microsysdeve/fjl_sdlk/电气控制原理.docx

山东里可涂装工程有限公司

自动电泳线电气控制原理

（热风循环）

7.5kw 风机启动 然后才能启动（燃烧机 三相电1.5kw）（金工热能表控制）

燃烧机关机后风机进入 延时0-30分钟（可调） 后自动关闭

烘道热能水循环

启动后由一台（百特工控）温控表（无需安装在面板上，放在控制柜内部），设定高报警，超出设定温度后启动1.5kw 水泵循环，低于设定温度，水泵自动停止工作.水泵为三相

悬挂链

由两台 三菱E740-3.7KW 变频器 同步运行，外接电位器，外接0-10v 转速表（可校准），外接急停，复位后方可自动运行（不需要写入PLC，安装面板按钮）

热水炉

燃烧机 0.75kw 两相电（由霍宇温控表单独控制启停） 水泵5.5kw三相电 关联四台 24v 电动执行器，执行器由霍宇温控表控制开与关，当四台执行器全部关闭状态，水泵自动停止，如任意一台执行器自动打开，水泵自动重启

目前张家港双荣的这部分控制有问题 需要整改

前处理

预脱脂 7.5kw水泵 主脱脂7.5kw水泵 主脱脂浸 5.5kw水泵 水洗一4kw水泵 水洗二浸 4kw水泵 纯水三 4kw水泵 硅烷7.5kw水泵 纯水四 4kw水泵 纯水五 4kw水泵 纯水六4kw水泵

电泳

轴封冷却泵 0.55kw 水泵启动后才能启动 电泳泵与超滤泵

电泳泵循环 15kw

UF1 4kw水泵 UF2 4kw 水泵 UF3 4kw水泵 纯水洗 4kw水泵

超滤泵 11kw ，有一个高液位保护，当水位过高超滤泵自动关闭，并且发出声光报警，声光报警器ALM1

反冲洗泵 1.5kw 单独启停

UF0喷淋 1.5kw

超滤液循环泵1.5kw 由低液位控制自动启停，液位到达自动启动（同时控制内循环电磁阀）

外循环 由中液位探针控制一个24v 电磁阀 开与关G1

内循环 由低液位探针控制一个24v 电磁阀 开与关G2

以上三个液位 共用一个 高 中 低 三针式水位控制器

一个16A 两相照明 时段控制可调

备用 手动控制一个220v 电磁阀 开与关.G3

备用电源 不需写入PLC

两相电源空开 2P 16A 5个

三相 16A 2个

三相40A 2个

三相63A 2个

注意要求：

所有马达均为三相380v

所有三相电机 需要热保护

总电源需要缺相保护

面板上有一个电流表，一个电压表

三个电源指示

一个总控制启动按钮，一个总控急停

金工热能 技术电话：张工18962452610
