microsysdeve/fjl_sdlk/热水炉.pdf

## 热水炉

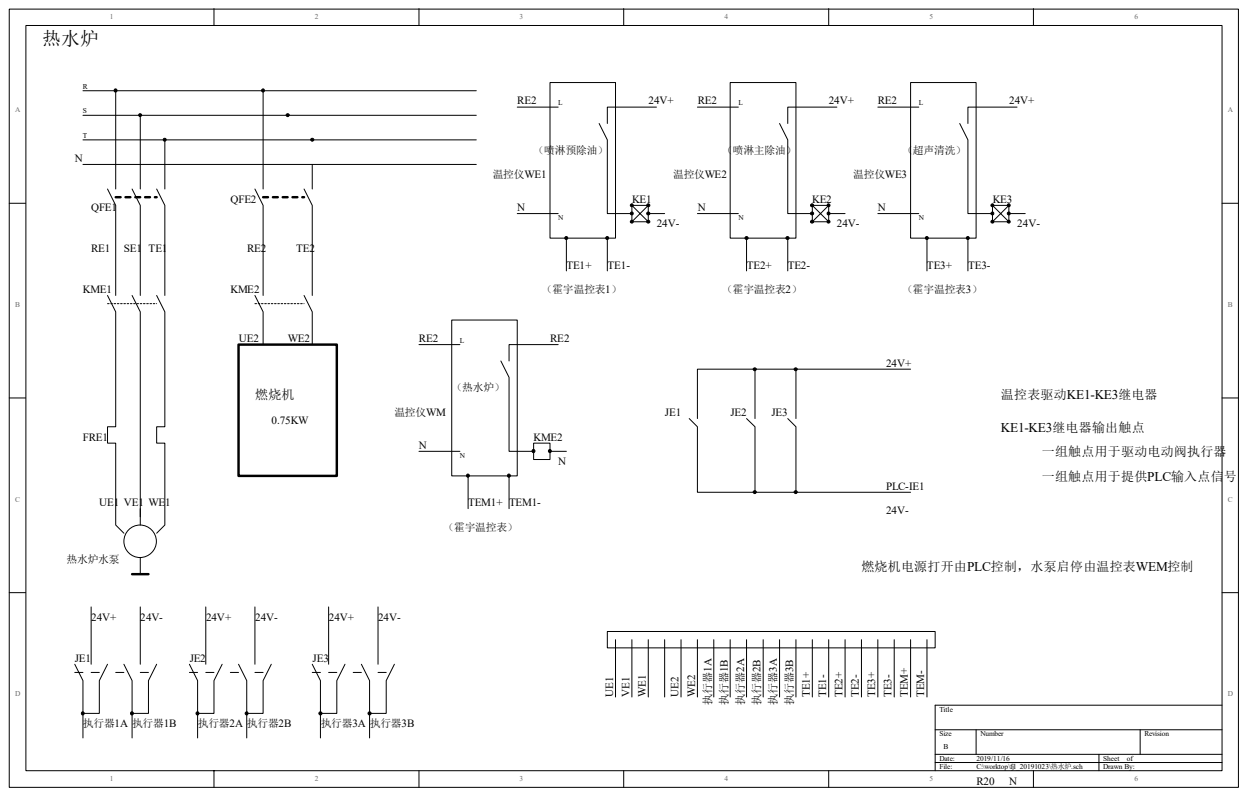
[picture p1: page 1]
Title; KME1; QFE1; FRE1; KME2; QFE2; 热水炉水泵; 燃烧机; 温控仪WE2; PLC-IE1; 执行器2B; 执行器3A; 执行器3B; 执行器2A; 执行器1B; 执行器1A; （霍宇温控表2）; 温控仪WE3; （霍宇温控表3）; 温控仪WE1; （霍宇温控表1）; 执行器1A 执行器1B; 24V- 执行器2A 执行器2B; 24V- 执行器3A 执行器3B; 温控表驱动KE1-KE3继电器; KE1-KE3继电器输出触点; 一组触点用于驱动电动阀执行器; 一组触点用于提供PLC输入点信号; 温控仪WM; （霍宇温控表）; TEM1+; TEM1-; TEM+; TEM-; 燃烧机电源打开由PLC控制，水泵启停由温控表WEM控制; （喷淋预除油）; （超声清洗） （喷淋主除油）; （热水炉）

Size B | Number | Revision

1 2 3 4 | Date: 2019/11/16 Sheet of File: C:\worktop\fjl_20191023\热水炉.sch Drawn By: 5 R20 N 6
