microsysdeve/fjl_sdlk/fjl_sdlk.pdf

# 山东里可涂装工程有限公司

# 自动电泳线电气控制原理

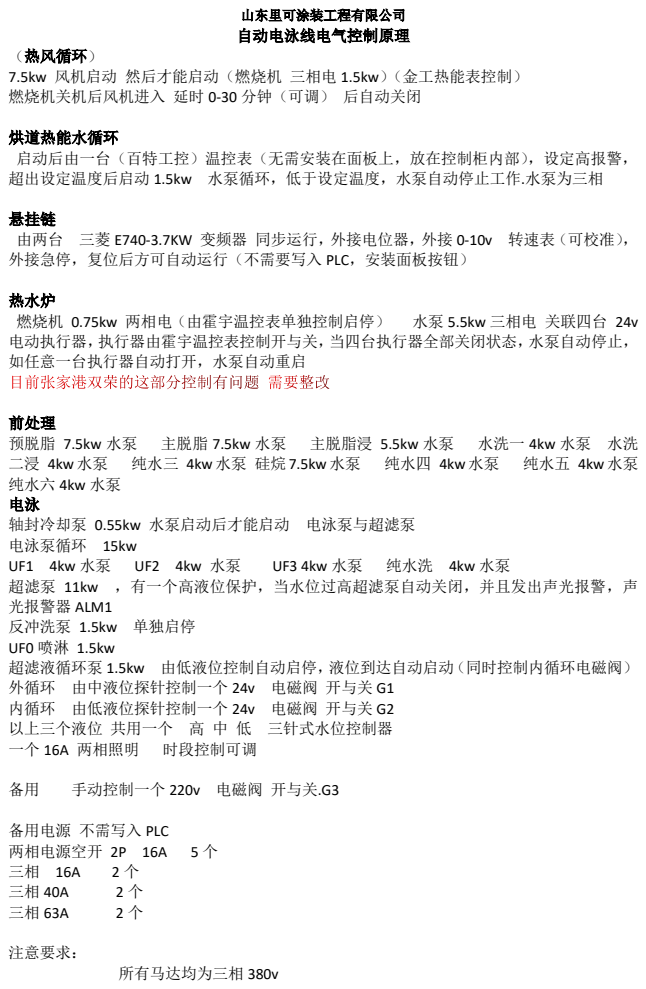
[picture p2: page 1]
燃烧机 0.75kw 两相电（由霍宇温控表单独控制启停）; 水泵 5.5kw 三相电 关联四台 24v; 预脱脂 7.5kw 水泵; 主脱脂 7.5kw 水泵; 主脱脂浸 5.5kw 水泵; 水洗一 4kw 水泵 水洗; 纯水三 4kw 水泵 硅烷 7.5kw 水泵; 纯水四 4kw 水泵; 纯水五 4kw 水泵; 纯水洗 4kw 水泵; 一个 16A 两相照明; 时段控制可调; 手动控制一个 220v 电磁阀 开与关.G3; 两相电源空开 2P 16A; 注意要求：; 所有马达均为三相 380v

（热风循环）
7.5kw 风机启动 然后才能启动（燃烧机 三相电 1.5kw）（金工热能表控制）
燃烧机关机后风机进入 延时 0-30 分钟（可调） 后自动关闭

烘道热能水循环
启动后由一台（百特工控）温控表（无需安装在面板上，放在控制柜内部），设定高报警，
超出设定温度后启动 1.5kw 水泵循环，低于设定温度，水泵自动停止工作.水泵为三相

悬挂链
由两台 三菱 E740-3.7KW 变频器 同步运行，外接电位器，外接 0-10v 转速表（可校准），
外接急停，复位后方可自动运行（不需要写入 PLC，安装面板按钮）

热水炉
电动执行器，执行器由霍宇温控表控制开与关，当四台执行器全部关闭状态，水泵自动停止，
如任意一台执行器自动打开，水泵自动重启

前处理
纯水六 4kw 水泵
轴封冷却泵 0.55kw 水泵启动后才能启动 电泳泵与超滤泵
电泳泵循环 15kw
超滤泵 11kw ，有一个高液位保护，当水位过高超滤泵自动关闭，并且发出声光报警，声
光报警器 ALM1
反冲洗泵 1.5kw 单独启停
超滤液循环泵 1.5kw 由低液位控制自动启停，液位到达自动启动（同时控制内循环电磁阀）
外循环 由中液位探针控制一个 24v 电磁阀 开与关 G1
内循环 由低液位探针控制一个 24v 电磁阀 开与关 G2
以上三个液位 共用一个 高 中 低 三针式水位控制器

备用电源 不需写入 PLC

# 所有三相电机 需要热保护 总电源需要缺相保护 面板上有一个电流表，一个电压表 三个电源指示 一个总控制启动按钮，一个总控急停

# 金工热能 技术电话：张工 18962452610

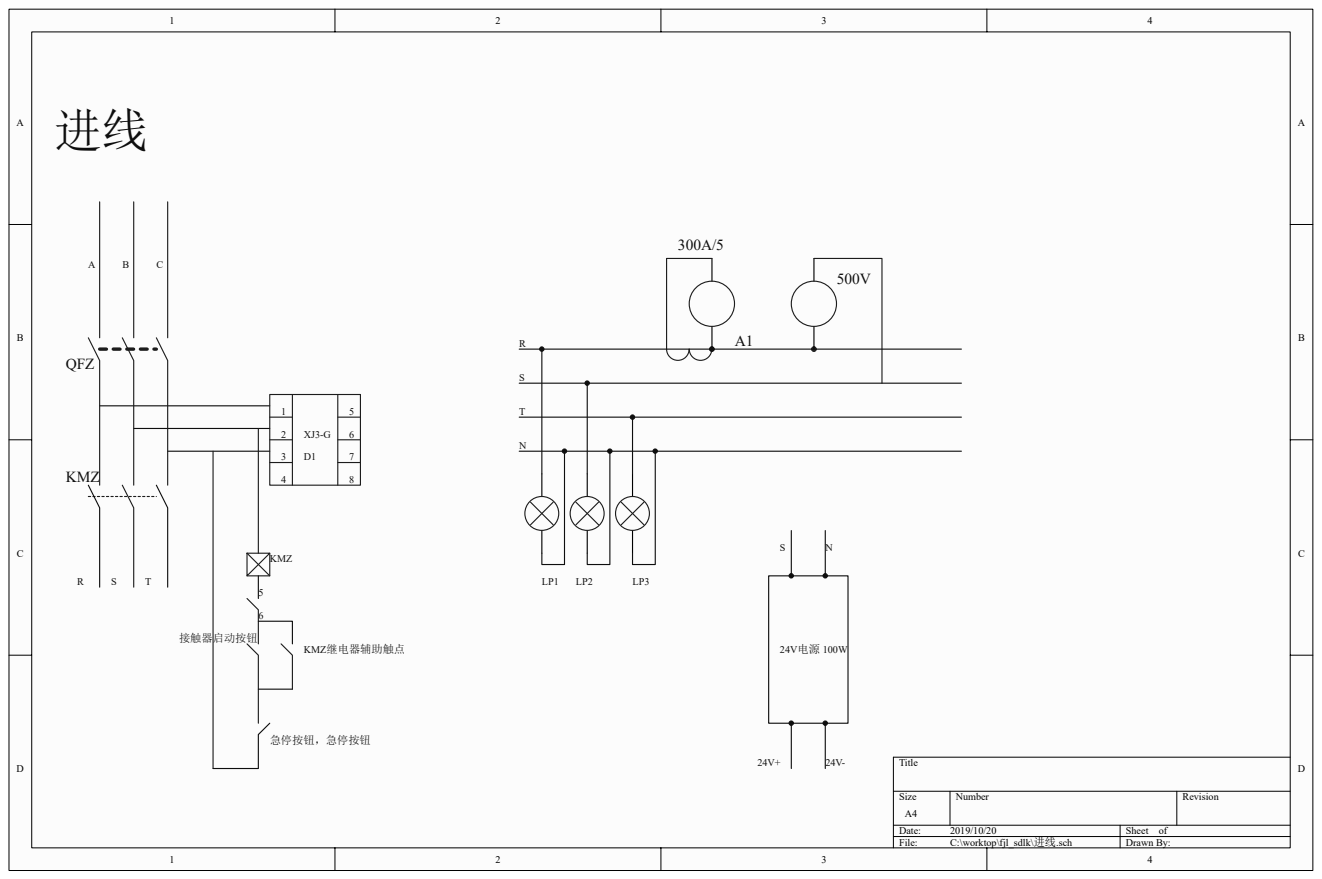
[picture p3: page 3]
Title; KMZ; QFZ; 24V电源 100W; 急停按钮，急停按钮 KMZ继电器辅助触点 接触器启动按钮

Size A4 | Number | Revision

Date: 2019/10/20 | Sheet of
File: C:\worktop\fjl_sdlk\进线.sch | Drawn By:

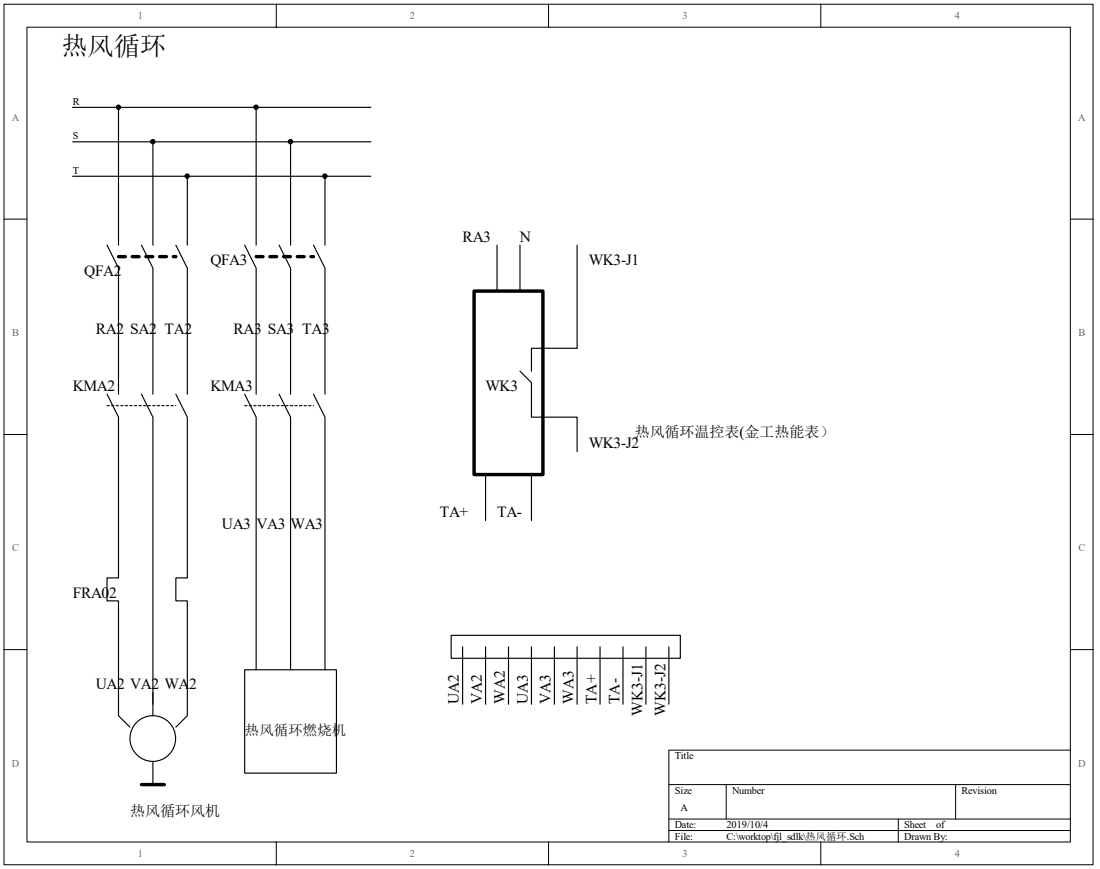
[picture p4: page 4]
Title; KMA2; QFA2; FRA02; KMA3; QFA3; 热风循环燃烧机; 热风循环风机; 热风循环温控表(金工热能表）; 热风循环

Size A | Number | Revision

Date: 2019/10/4 | Sheet of
File: C:\worktop\fjl_sdlk\热风循环.Sch | Drawn By:

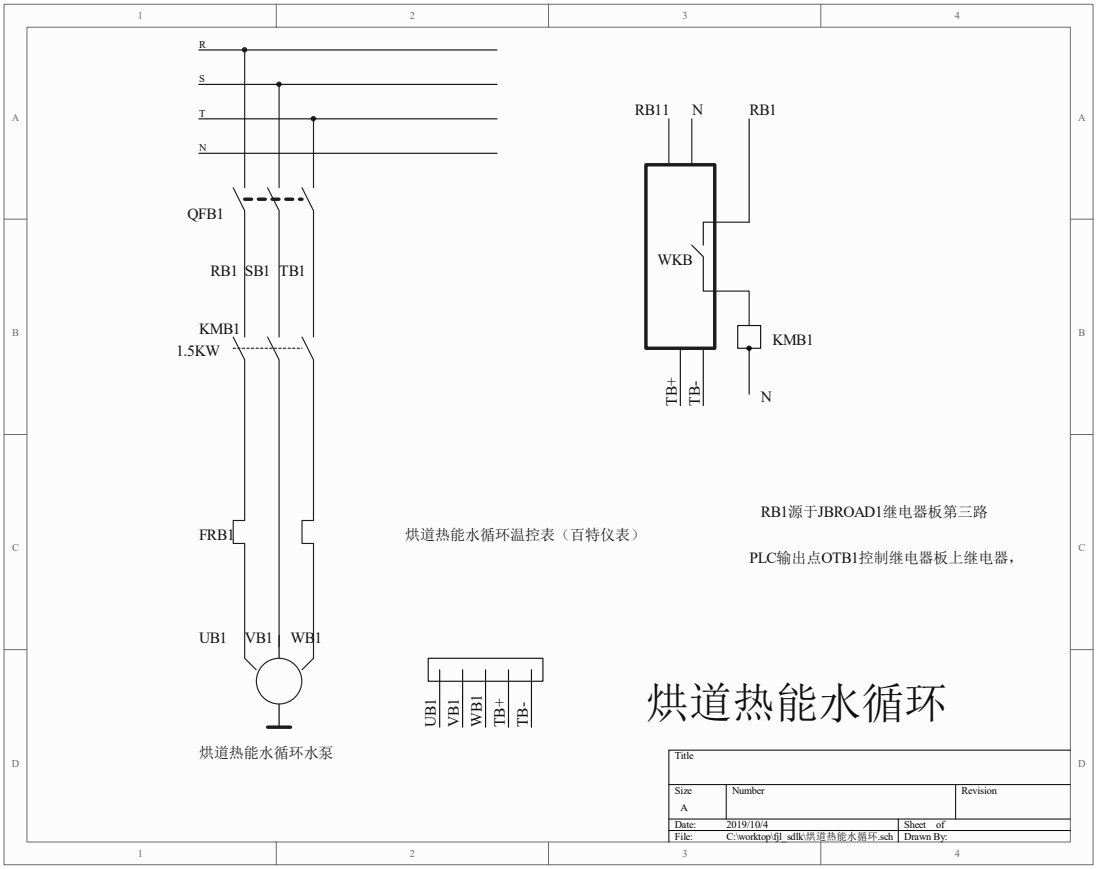
[picture p5: page 5]
Title; KMB1; QFB1; FRB1; 烘道热能水循环水泵; 烘道热能水循环温控表（百特仪表）; WKB; PLC输出点OTB1控制继电器板上继电器，; 烘道热能水循环; RB1源于JBROAD1继电器板第三路

Size A | Number | Revision

Date: 2019/10/4 | Sheet of
File: C:\worktop\fjl_sdlk\烘道热能水循环.sch | Drawn By:

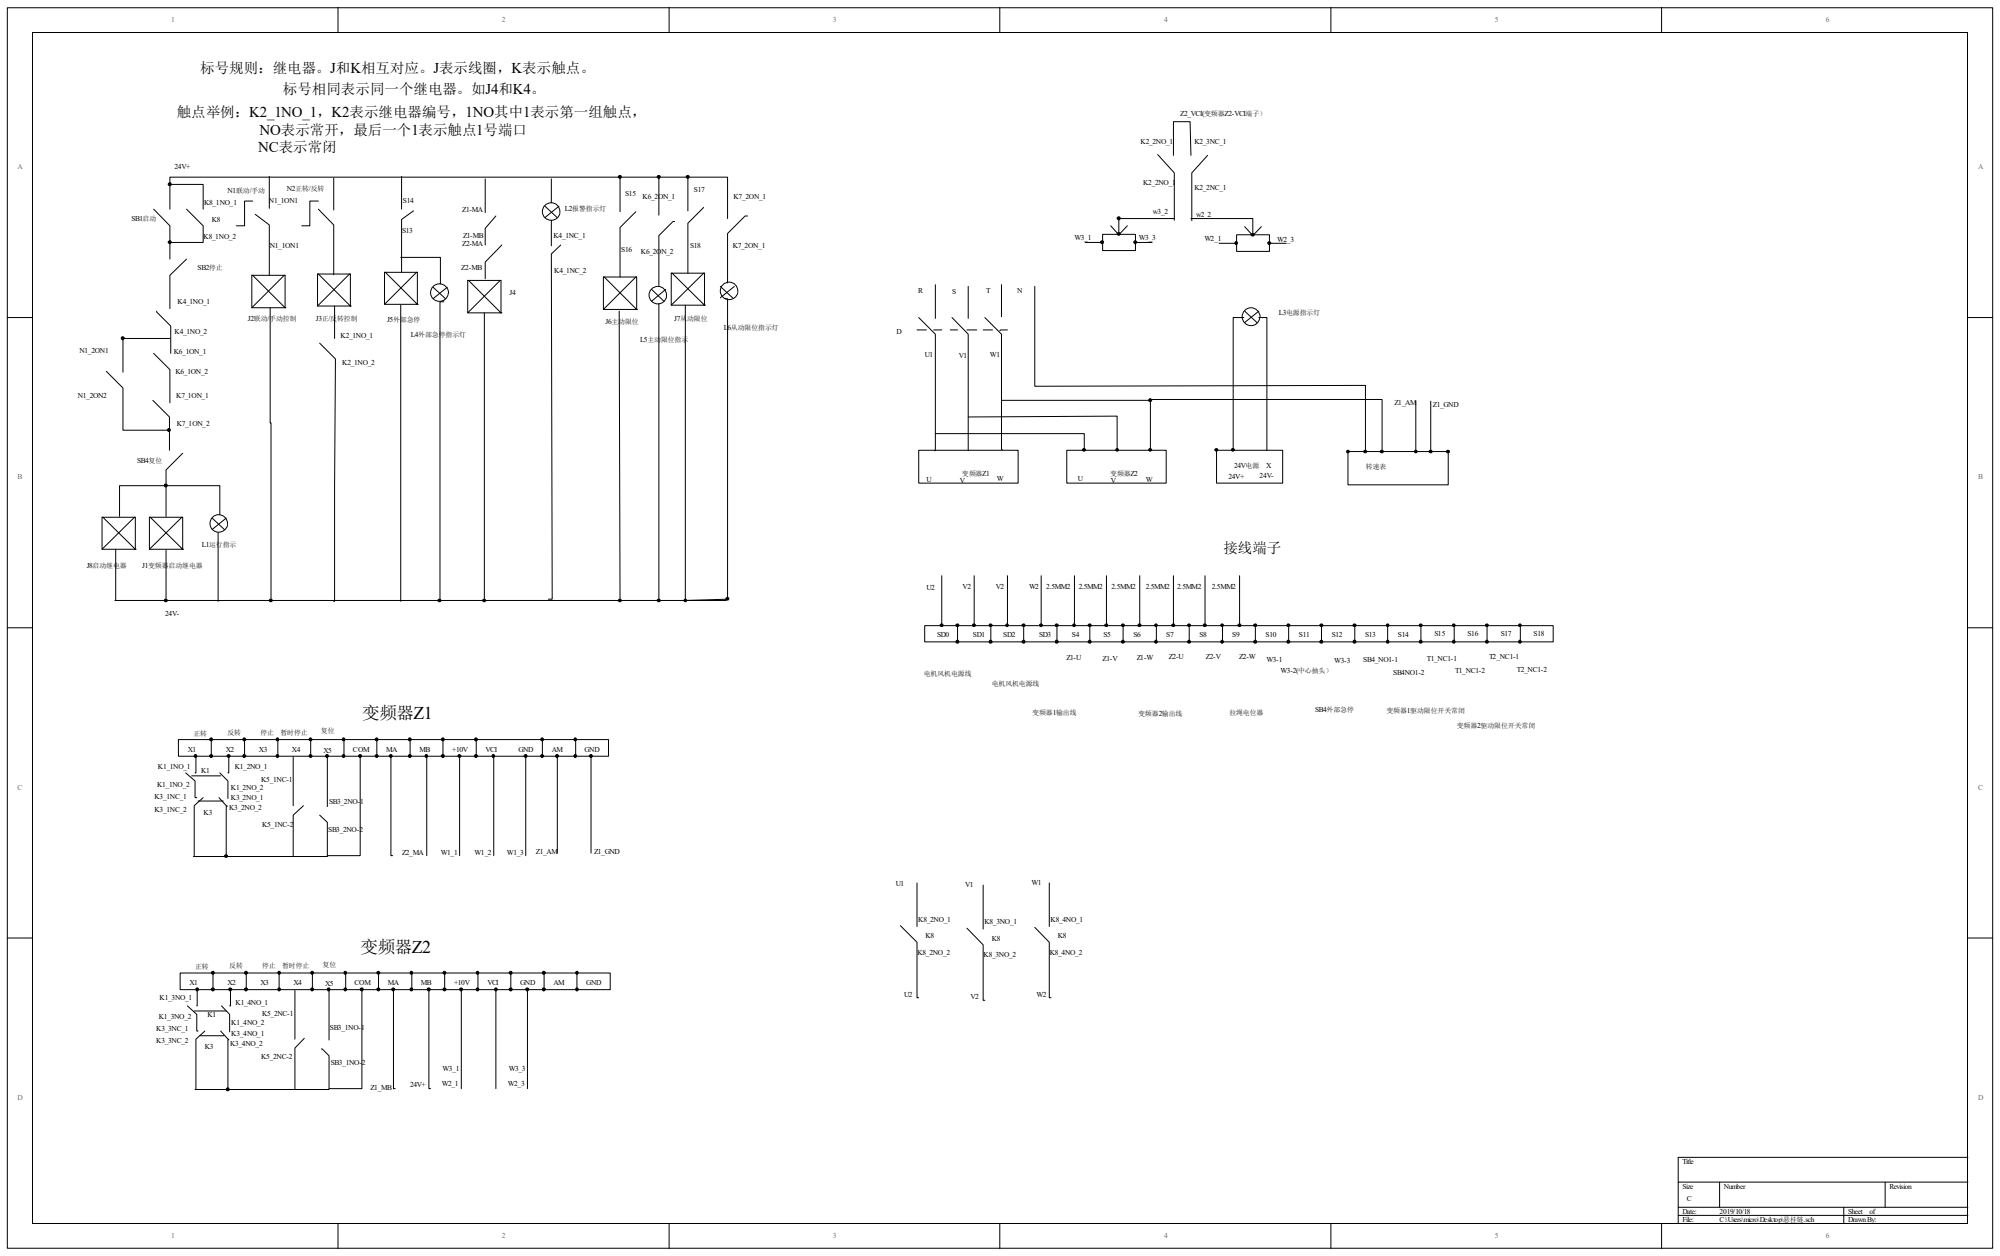
[picture p6: page 6]
Title; Size; Number; Revision; Date:; Sheet of; File:; C:\Users\micro\Desktop\悬挂链.sch; Drawn By:; COM; VCI; GND; 停止 暂时停止; J1变频器启动继电器; W 变频器Z1; W 变频器Z2; 24V电源 X; 变频器Z2; 变频器Z1; W3-2(中心抽头）; L2报警指示灯; J2联动/手动控制; J3正/反转控制; Z2_VCI(变频器Z2-VCI端子）; L1运行指示; SB4外部急停; J5外部急停; L3电源指示灯; L4外部急停指示灯; 转速表; Z1_GND; 变频器1输出线; 变频器2输出线; 拉绳电位器; 变频器1驱动限位开关常闭; 变频器2驱动限位开关常闭; J6主动限位; J7从动限位; L5主动限位指示; L6从动限位指示灯; 接线端子; J8启动继电器; 标号相同表示同一个继电器。如J4和K4。; 触点举例：K2_1NO_1，K2表示继电器编号，1NO其中1表示第一组触点， NO表示常开，最后一个1表示触点1号端口 NC表示常闭; 电机风机电源线

标号规则：继电器。J和K相互对应。J表示线圈，K表示触点。

N

### 温控仪WE2

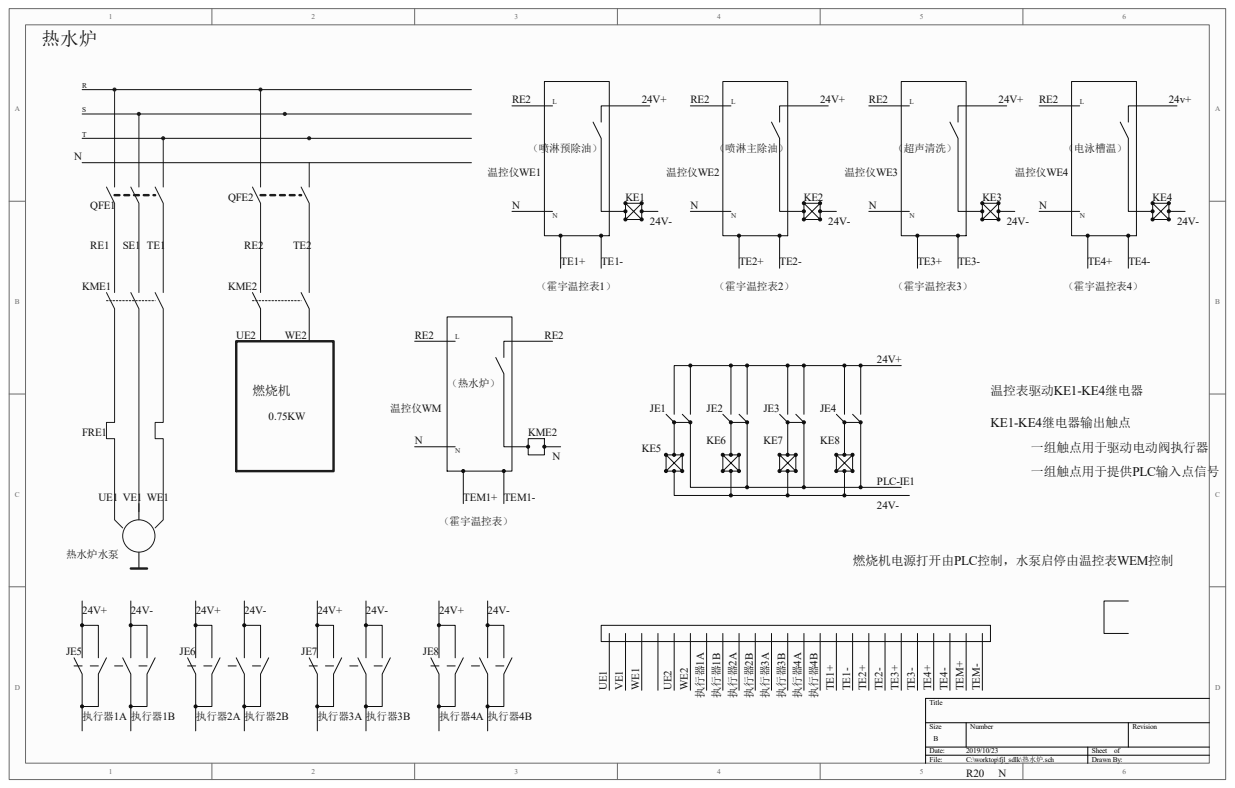
[picture p7: page 7]
Title; Size; Number; Revision; Date:; Sheet of; File:; C:\worktop\fjl_sdlk\热水炉.sch; Drawn By:; KME1; QFE1; FRE1; KME2; QFE2; 热水炉水泵; 燃烧机; PLC-IE1; JE1 UE¹; VE¹; WE¹; UE²; WE²; 执行器²B 执行器³A 执行器³B 执行器²A 执行器¹B 执行器¹A; （霍宇温控表2）; TE¹+; TE¹⁻; 温控仪WE3; （霍宇温控表3）; 温控仪WE4; （霍宇温控表4）; TE4- TE²+; TE²⁻; TE³+; TE³⁻; TE⁴+; TE⁴⁻ 执行器⁴A 执行器⁴B; 热水炉; 温控仪WE1; （霍宇温控表1）; 执行器1A 执行器1B; 执行器2A 执行器2B; 执行器3A 执行器3B; 执行器4A 执行器4B; 温控表驱动KE1-KE4继电器; KE1-KE4继电器输出触点; 一组触点用于驱动电动阀执行器; 一组触点用于提供PLC输入点信号; 温控仪WM; （霍宇温控表）; TEM1+; TEM1-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

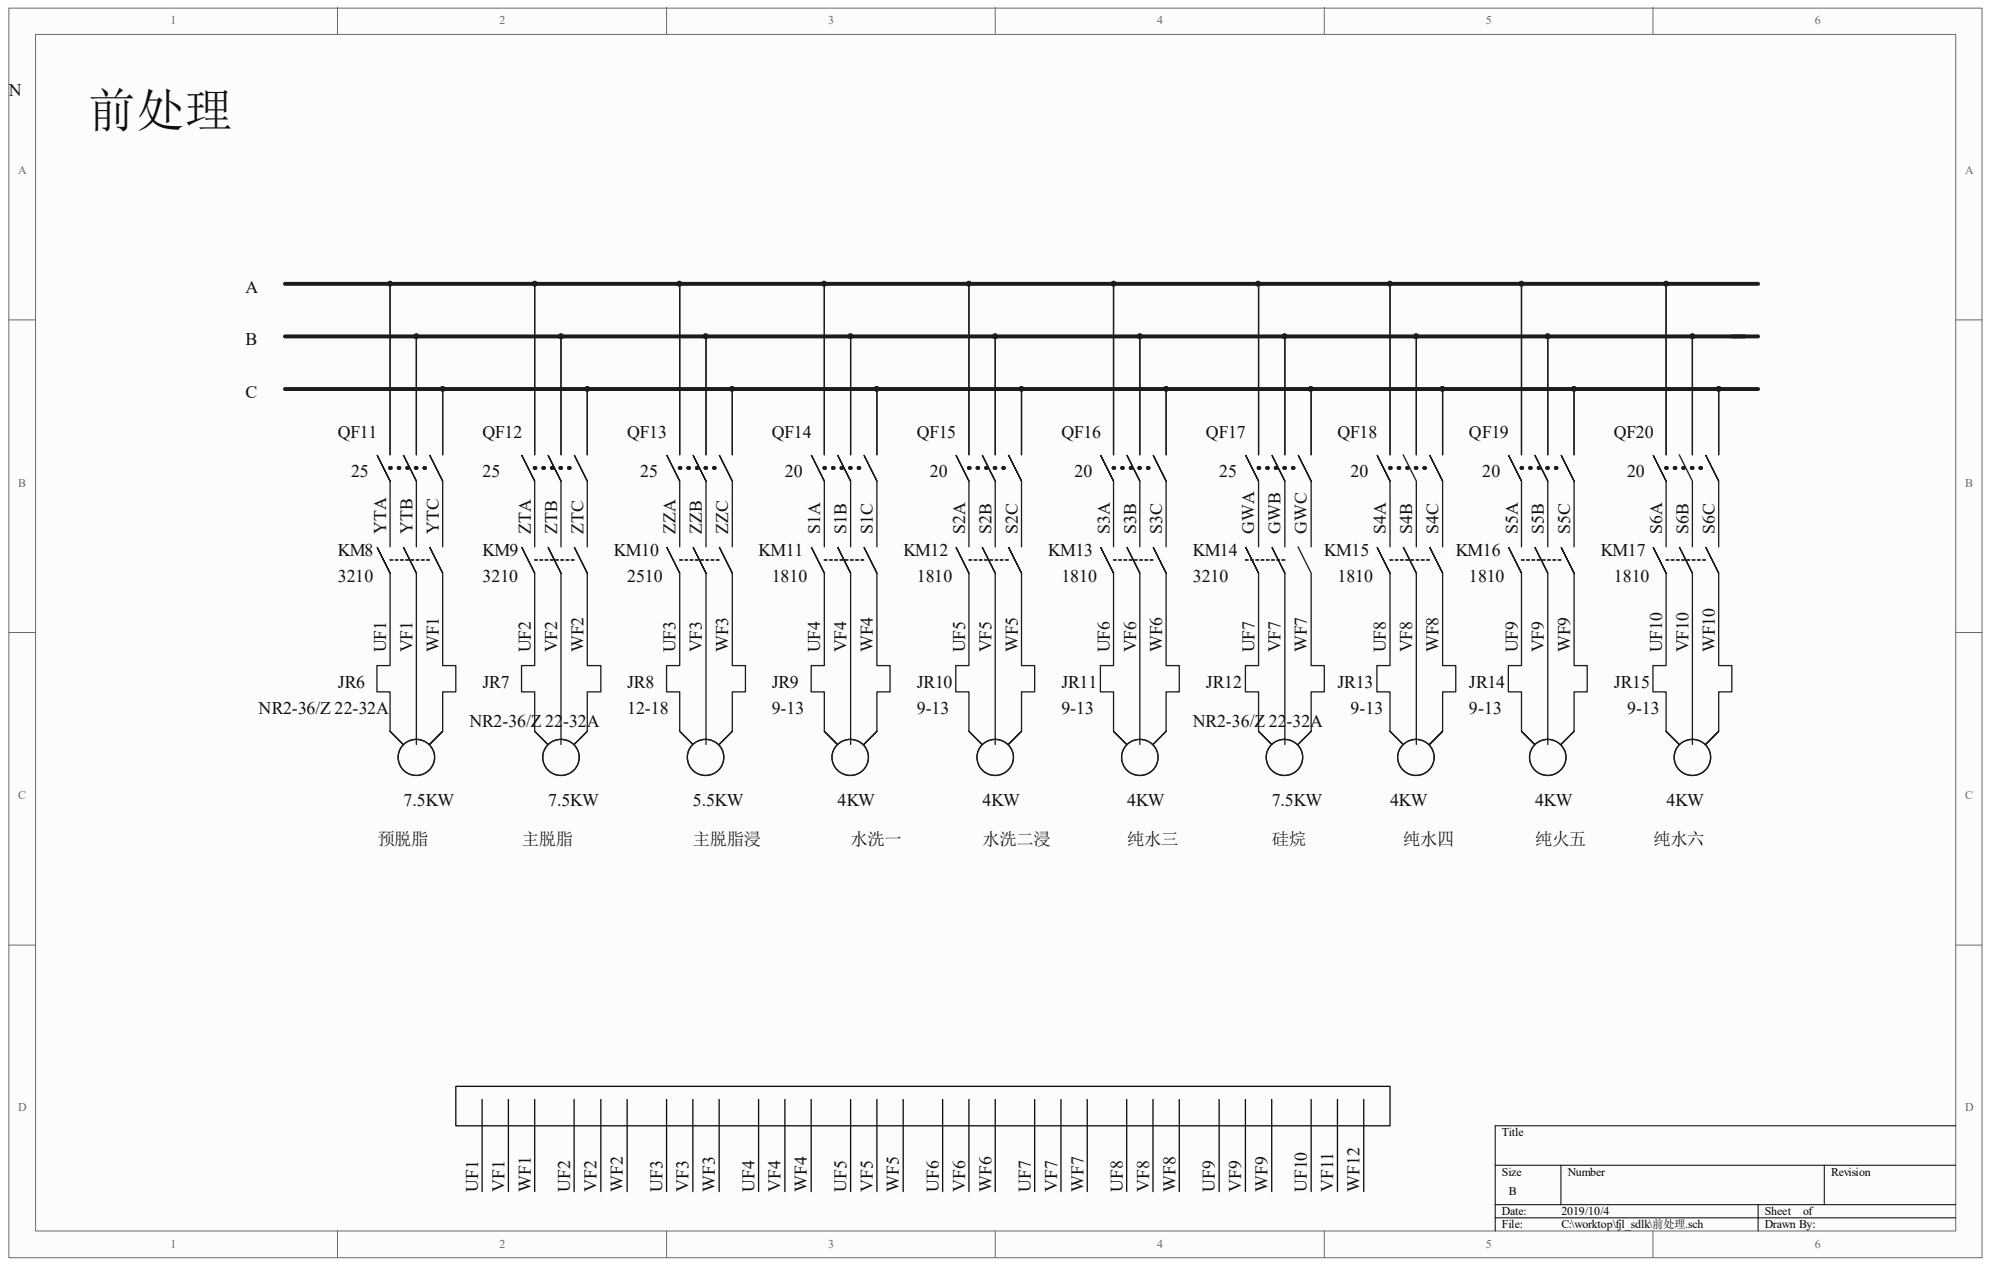
[picture p8: page 8]
Title; Size; Number; Revision; Date:; Sheet of; File:; C:\worktop\fjl_sdlk\前处理.sch; Drawn By:; 前处理; GWA; 预脱脂; 主脱脂; 主脱脂浸; YTA; YTB; YTC; 水洗一; 纯火五; 纯水六; 水洗二浸; 纯水三; 纯水四 硅烷; ZTA; ZTB; ZTC; ZZA; ZZB; ZZC; GWB; GWC

电泳 | JG³ | N

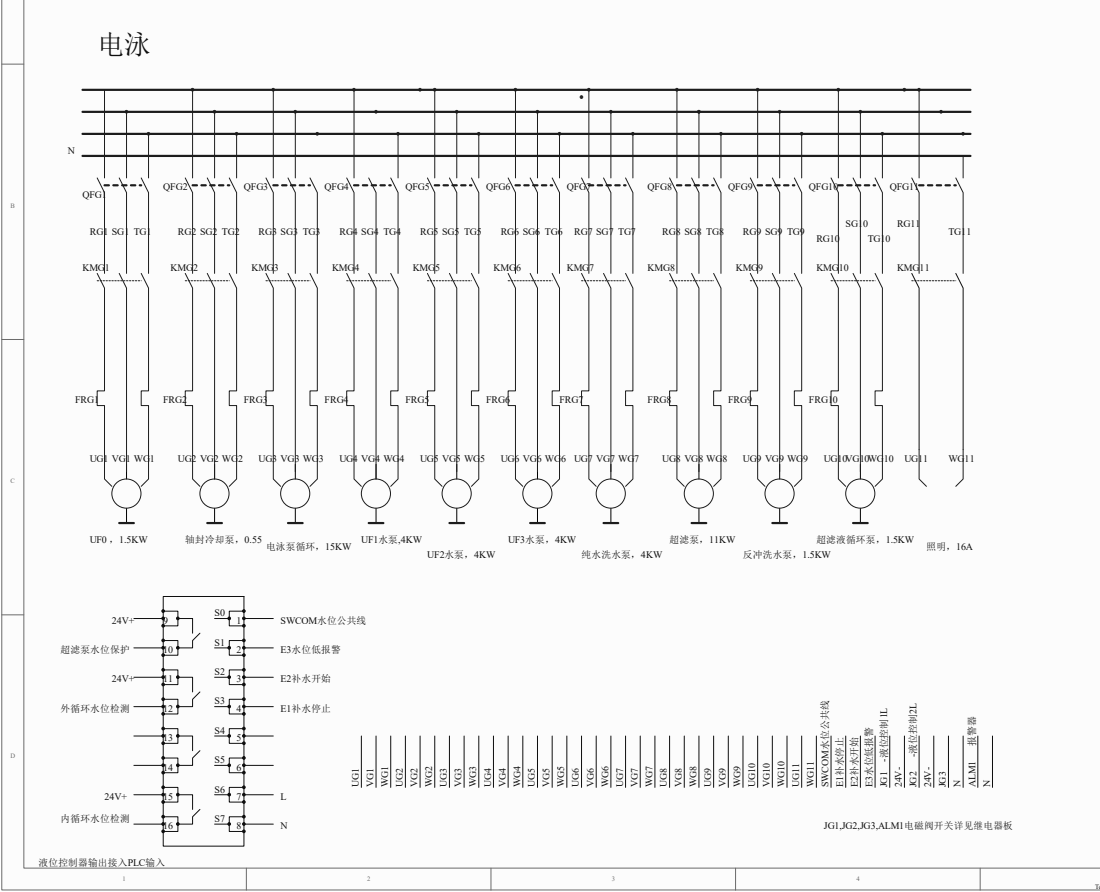
[picture p9: page 9]
KMG1; QFG1; FRG1; KMG2; QFG2; FRG2; KMG3; QFG3; FRG3; KMG4; QFG4; FRG4; KMG5; QFG5; FRG5; KMG6; QFG6; FRG6; KMG7; QFG7; FRG7; KMG8; QFG8; FRG8; KMG9; QFG9; FRG9; KMG10; QFG10; FRG10; KMG11; QFG11; 轴封冷却泵，0.55; 超滤泵，11KW 电泳泵循环，15KW; 超滤液循环泵，1.5KW; 纯水洗水泵，4KW; 反冲洗水泵，1.5KW; Text UG¹; VG¹; WG¹; UG²; VG²; WG²; UG³; VG³; WG³; UG⁴; VG⁴; WG⁴; UG⁵; VG⁵; WG⁵; UG⁶; VG⁶; WG⁶; UG⁷; VG⁷; WG⁷; UG⁸; VG⁸; WG⁸; UG⁹; VG⁹; WG⁹; UG¹⁰; VG¹⁰; WG¹⁰; UG¹¹; WG¹¹; 照明，16A SWCOM水位公共线; E²补水开始 E¹补水停止; E³水位低报警; JG¹ ⁻液位控制¹L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

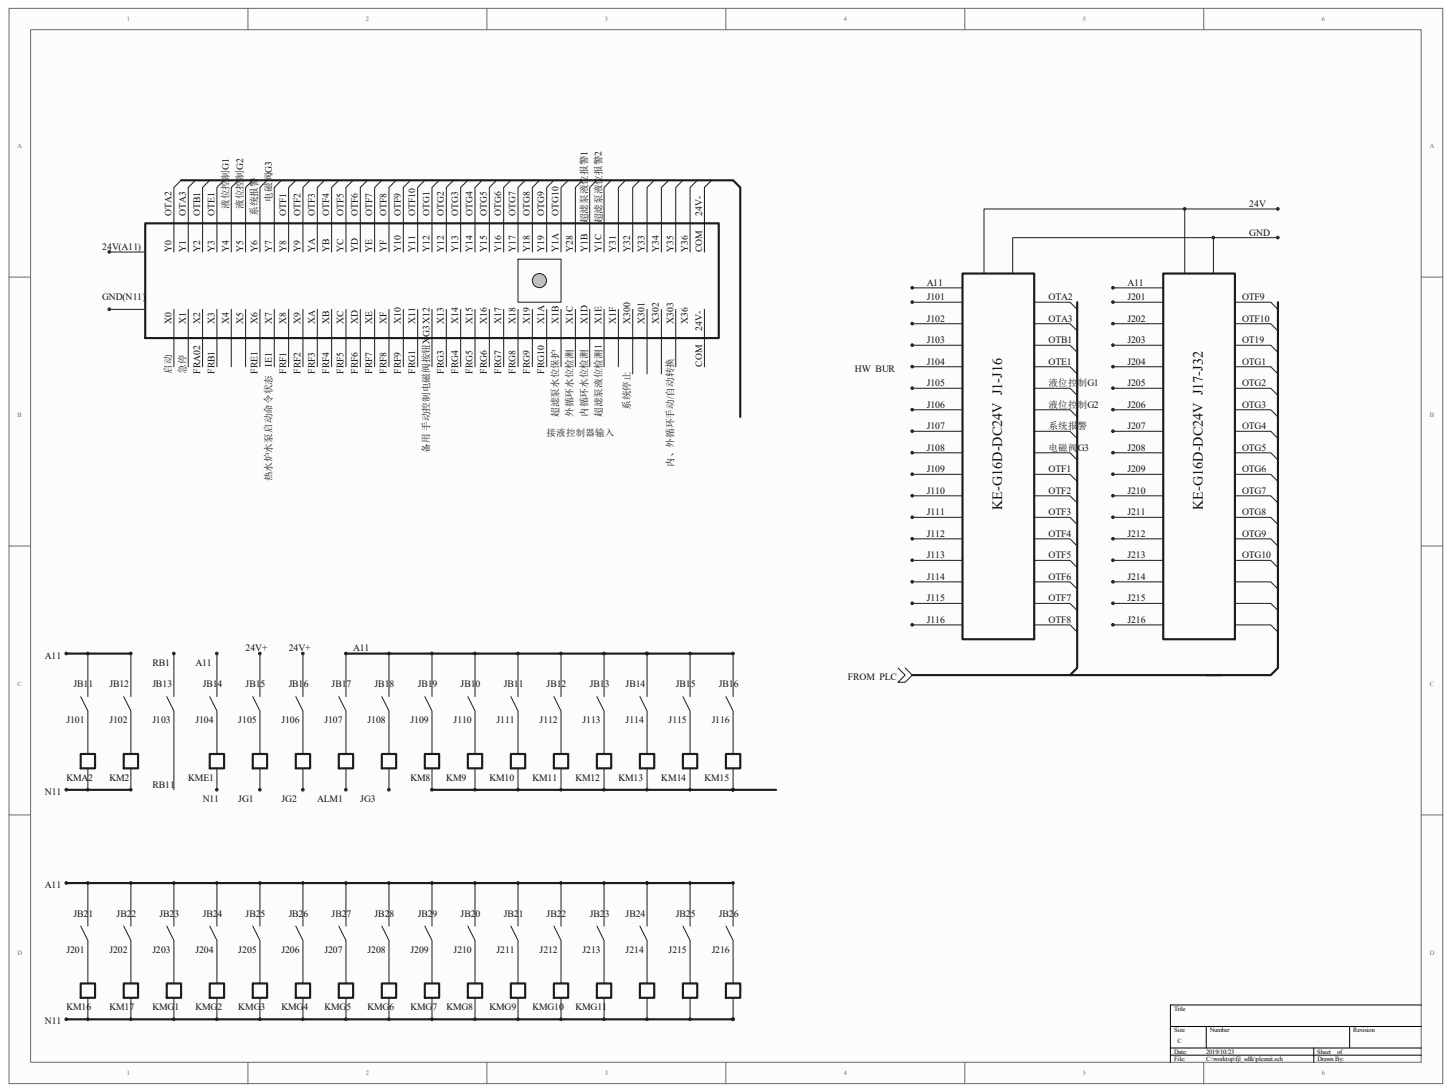
[picture p10: page 10]

液位控制G1 液位控制G2 超滤泵液位检测1 超滤泵液位报警1 超滤泵液位报警2 OTA3 系统报警 Y0 Y1 Y2 Y3 Y4 Y5 Y6 Y7 Y8 Y9 YAYBYCYDYEYF Y10 Y11 Y12 Y12 Y13 Y14 Y15 Y16 Y17 Y18 Y19 Y1A Y28 Y1B Y1C Y31 Y32 Y33 Y34 Y35 Y36 X0 X1 X2 X3 X4 X5 X6 X7 X8 X9 XAXBXCXDXEXF X10 X11 X12 X13 X14 X15 X16 X17 X18 X19 X1A X1B X1C X1D X1E X1F X300 X301 X302 X303 X36 启动急停 OTG10 COM 24V- COM 24V- 系统停止 内、外循环手动/自动转换 OTF10 电磁阀G3 OTE1

备用

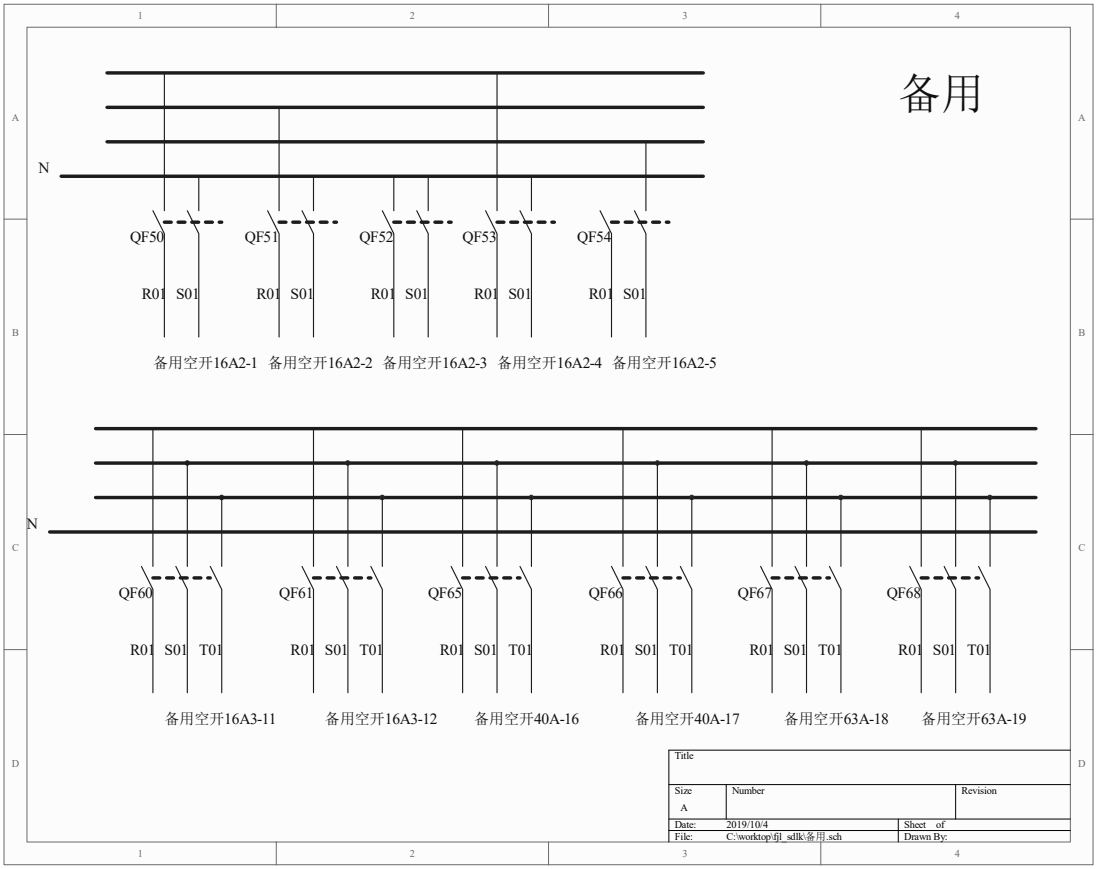
[picture p11: page 11]
Title; 备用空开16A2-1; 备用空开16A3-11; 备用空开16A3-12; 备用空开40A-16; 备用空开40A-17; 备用空开63A-18; 备用空开63A-19; 备用空开16A2-2 备用空开16A2-3 备用空开16A2-4 备用空开16A2-5

Size A | Number | Revision

Date: 2019/10/4 | Sheet of
File: C:\worktop\fjl_sdlk\备用.sch | Drawn By:

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
