microsysdeve/fjl_sdlk/plcunit.pdf

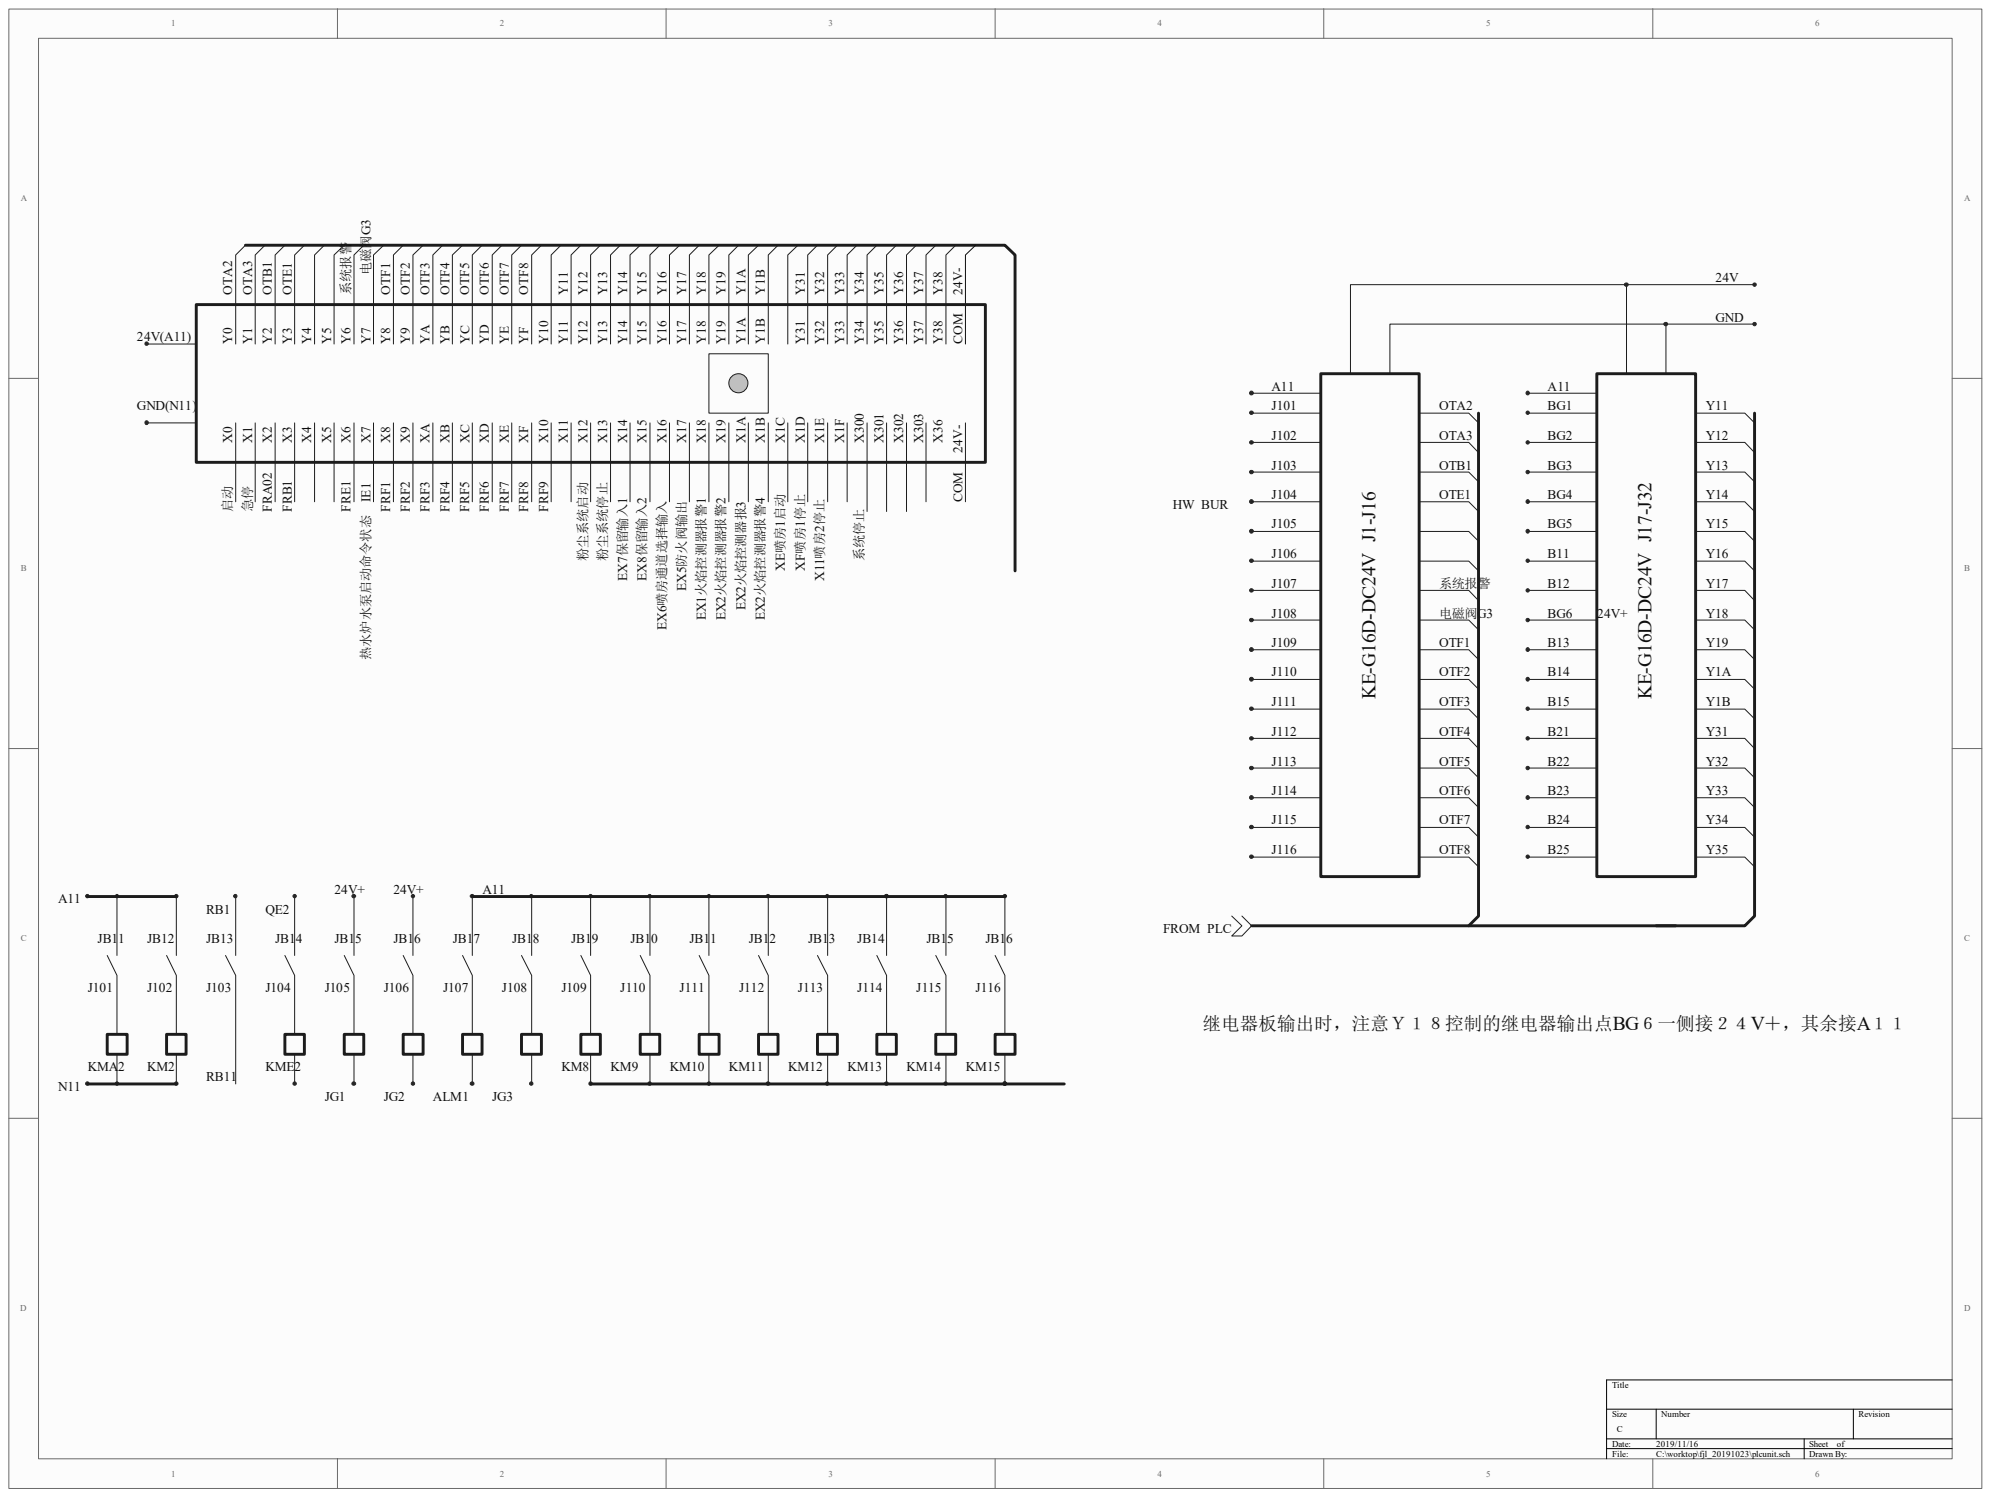
[picture p12: page 1]

Size C | Number | Revision

1 2 3 4 5 | File: Date: C:\worktop\fjl_20191023\plcunit.sch 2019/11/16 Sheet of Drawn By: 6
