microsysdeve/fjl_sdlk/前处理.pdf

# 前处理

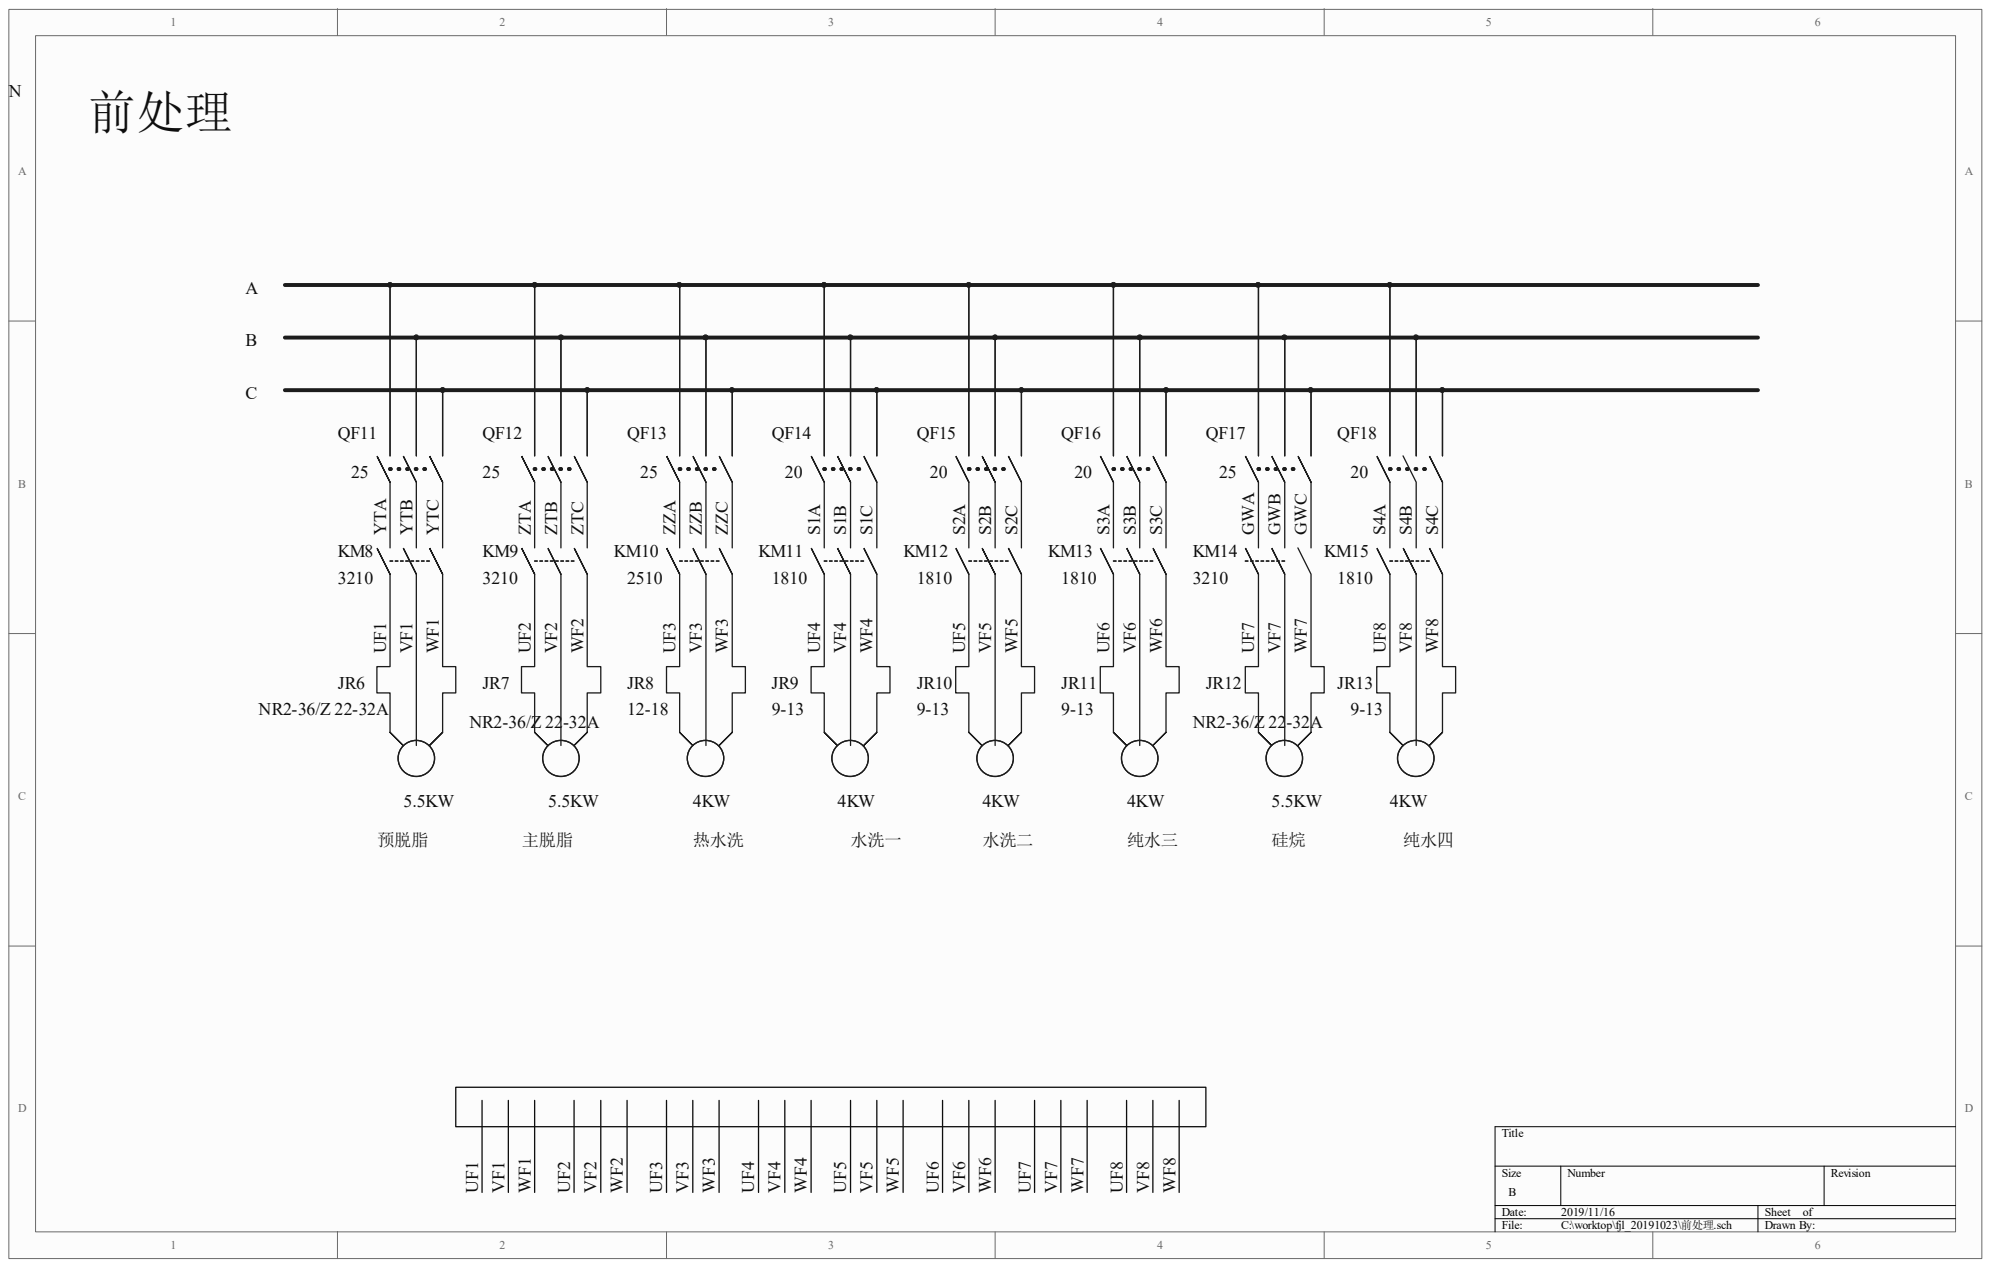
[picture p13: page 1]
Title; GWA; 预脱脂; 主脱脂; 热水洗; YTA; YTB; YTC; 水洗一; 水洗二; 纯水三; 纯水四 硅烷; ZTA; ZTB; ZTC; ZZA; ZZB; ZZC; GWB; GWC

Size B | Number | Revision

1 2 3 4 | Date: 2019/11/16 Sheet of File: C:\worktop\fjl_20191023\前处理.sch Drawn By: 5 6
