microsysdeve/fjl_sdlk/悬挂链.pdf

# 标号相同表示同一个继电器。如J4和K4。

# 标号规则：继电器。J和K相互对应。J表示线圈，K表示触点。

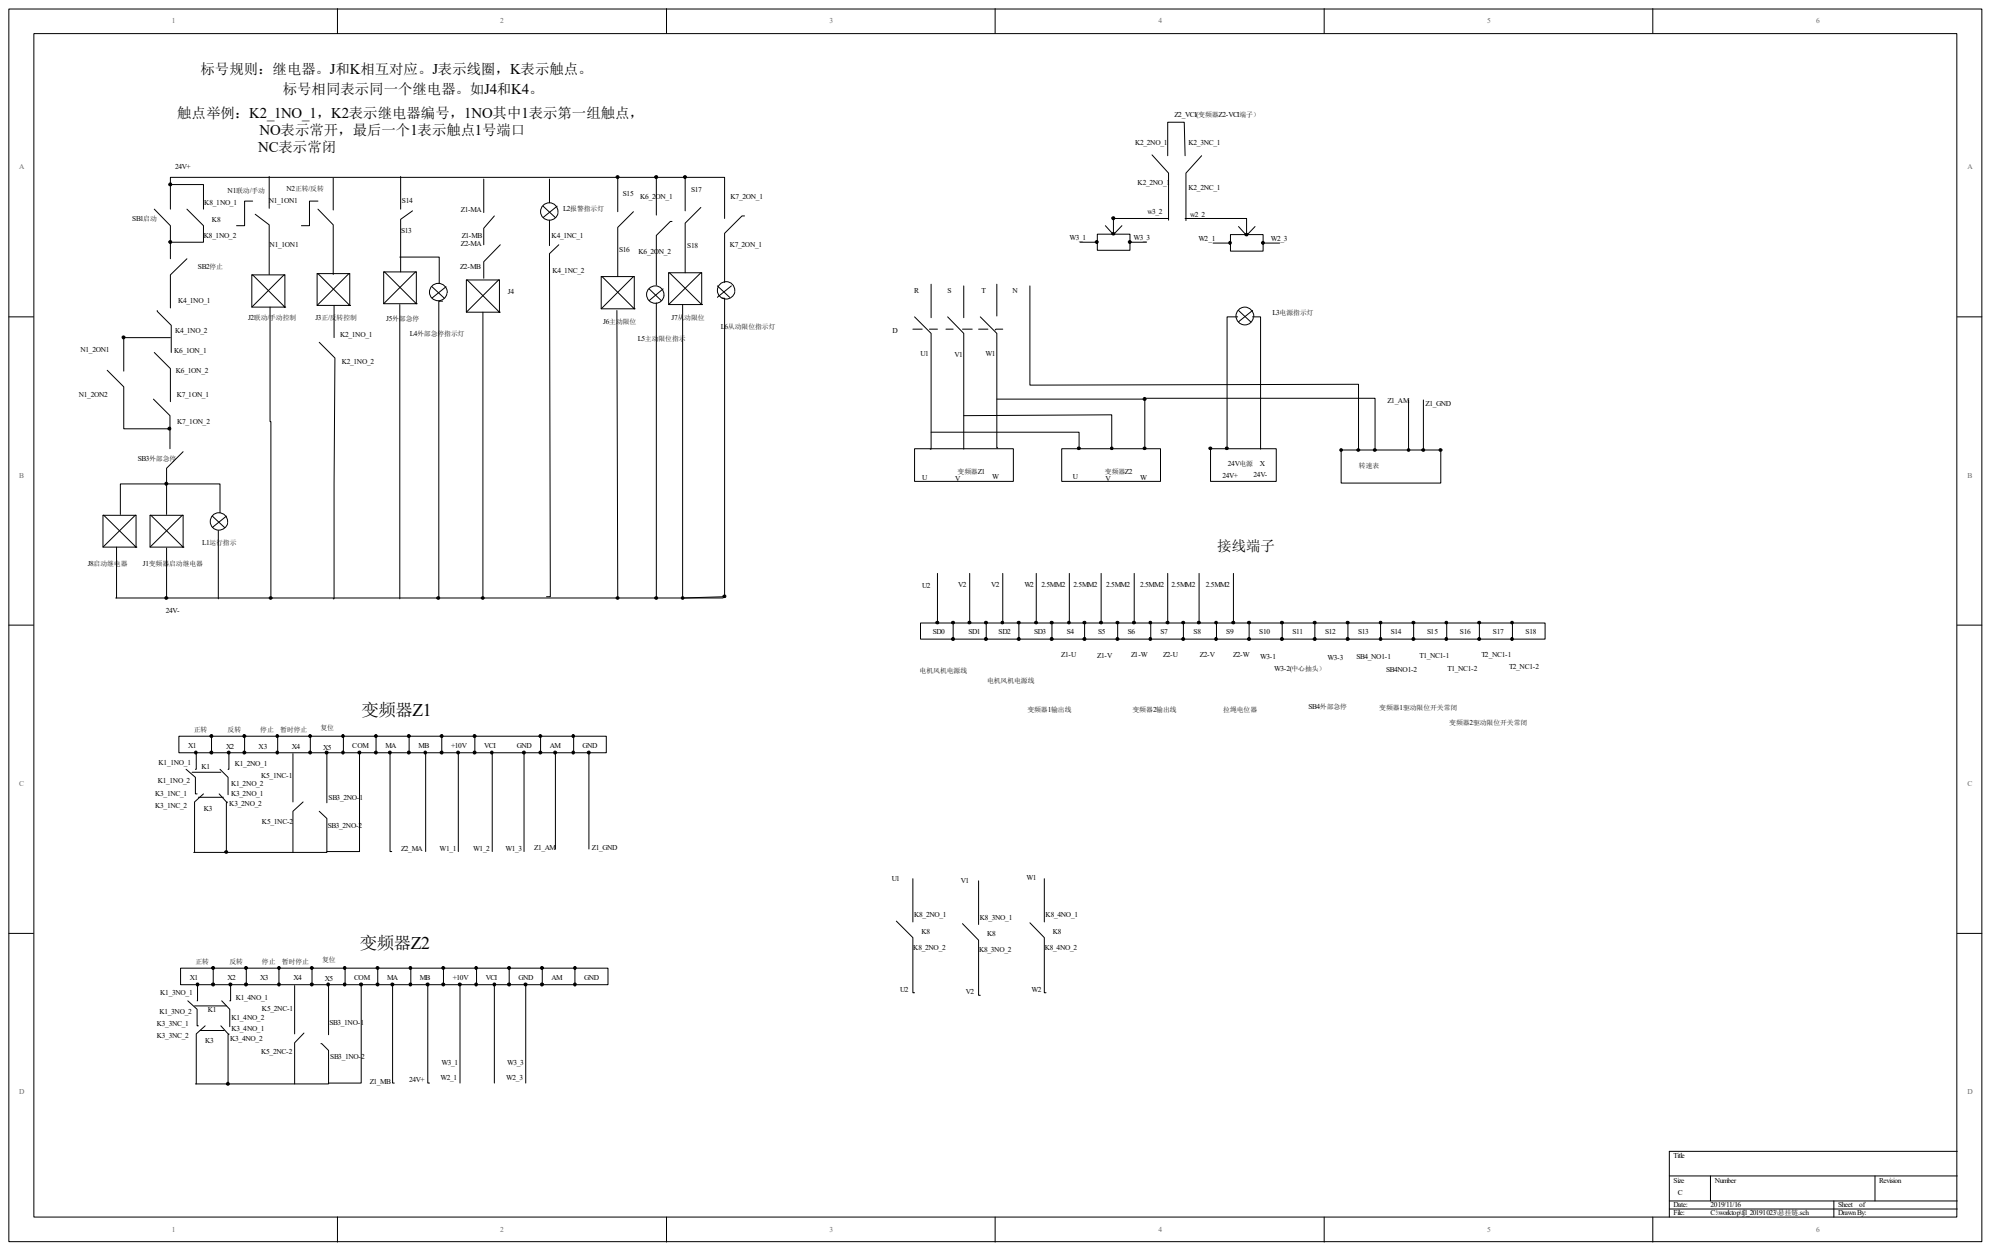
[picture p14: page 1]
Title; Size; Number; Revision; File:; C:\worktop\fjl_20191023\悬挂链.sch; Drawn By:; COM; VCI; GND; 停止 暂时停止; J1变频器启动继电器; W 变频器Z1; W 变频器Z2; 24V电源 X; 变频器Z2; 变频器Z1; W3-2(中心抽头）; L2报警指示灯; J2联动/手动控制; J3正/反转控制; Z2_VCI(变频器Z2-VCI端子）; L1运行指示; SB4外部急停; J5外部急停; L3电源指示灯; SB3外部急停; L4外部急停指示灯; 转速表; Z1_GND; 变频器1输出线; 变频器2输出线; 拉绳电位器; 变频器1驱动限位开关常闭; 变频器2驱动限位开关常闭; J6主动限位; J7从动限位; L5主动限位指示; L6从动限位指示灯; 接线端子; J8启动继电器; 触点举例：K2_1NO_1，K2表示继电器编号，1NO其中1表示第一组触点， NO表示常开，最后一个1表示触点1号端口 NC表示常闭; 电机风机电源线

1 2 3 4 5 | Date: 2019/11/16 Sheet of 6
