microsysdeve/fjl_sdlk/烘道热能水循环.pdf

RB11 | N | RB1

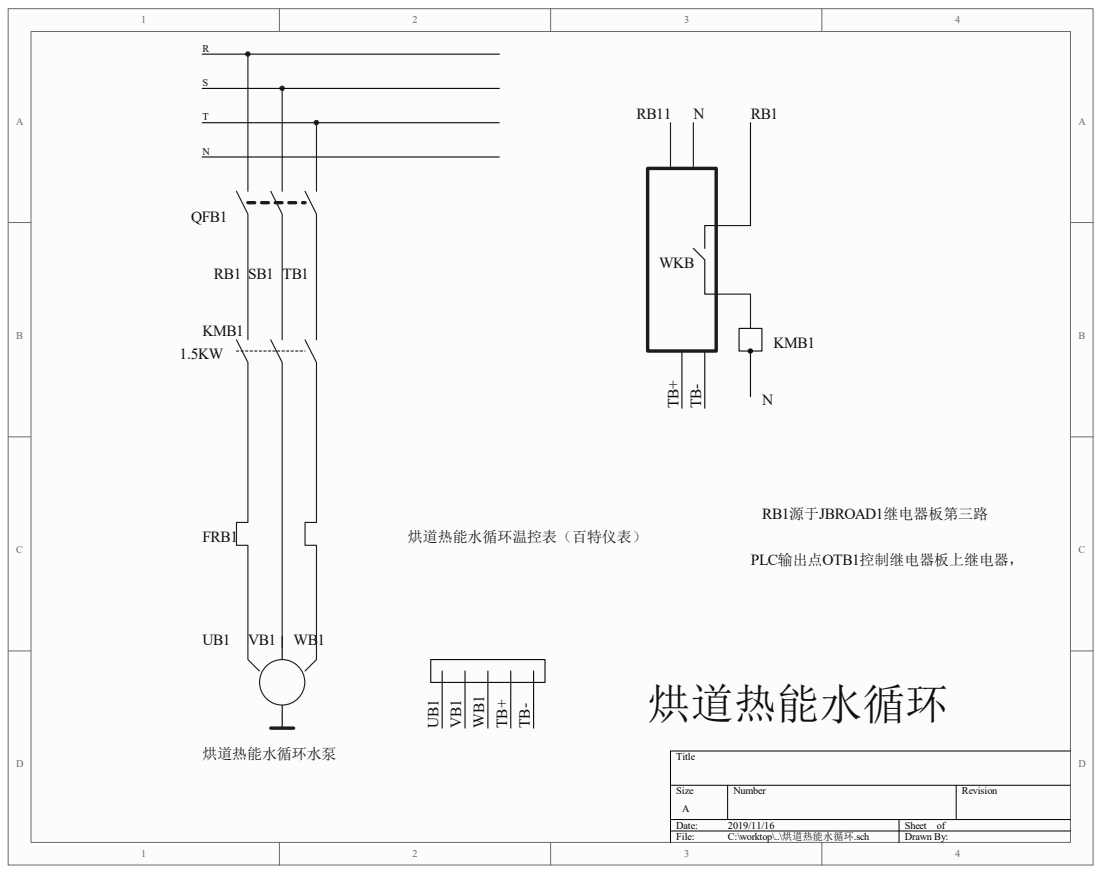
[picture p15: page 1]
Title; KMB1; QFB1; FRB1; 烘道热能水循环水泵; 烘道热能水循环温控表（百特仪表）; WKB; PLC输出点OTB1控制继电器板上继电器，; 烘道热能水循环; RB1源于JBROAD1继电器板第三路

Size A | Number | Revision

Date: 2019/11/16 | Sheet of
File: C:\worktop\..\烘道热能水循环.sch | Drawn By:
