microsysdeve/fjl_sdlk/热风循环.pdf

# 热风循环

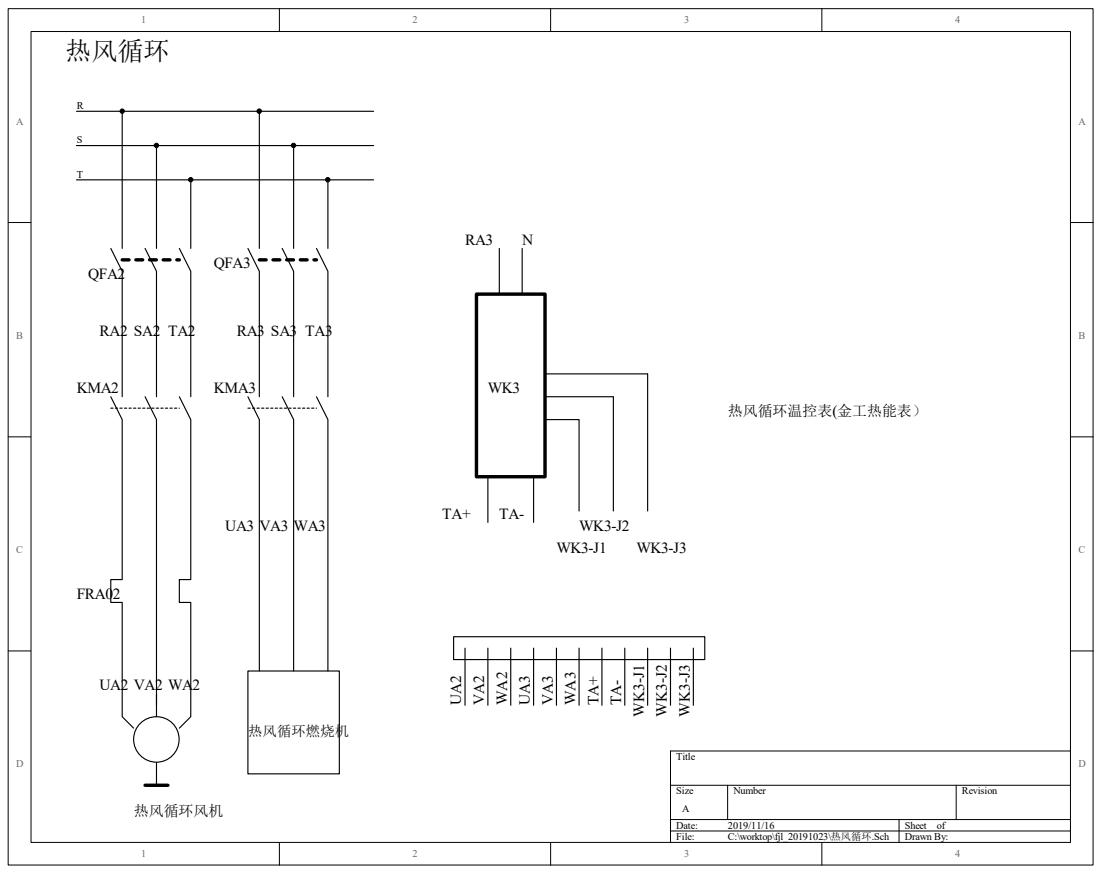
[picture p16: page 1]
Title; KMA2; QFA2; FRA02; KMA3; QFA3; 热风循环燃烧机; 热风循环风机; 热风循环温控表(金工热能表）

Size A | Number | Revision

Date: 2019/11/16 | Sheet of
File: C:\worktop\fjl_20191023\热风循环.Sch | Drawn By:
