microsysdeve/fjl_sdlk/进线.pdf

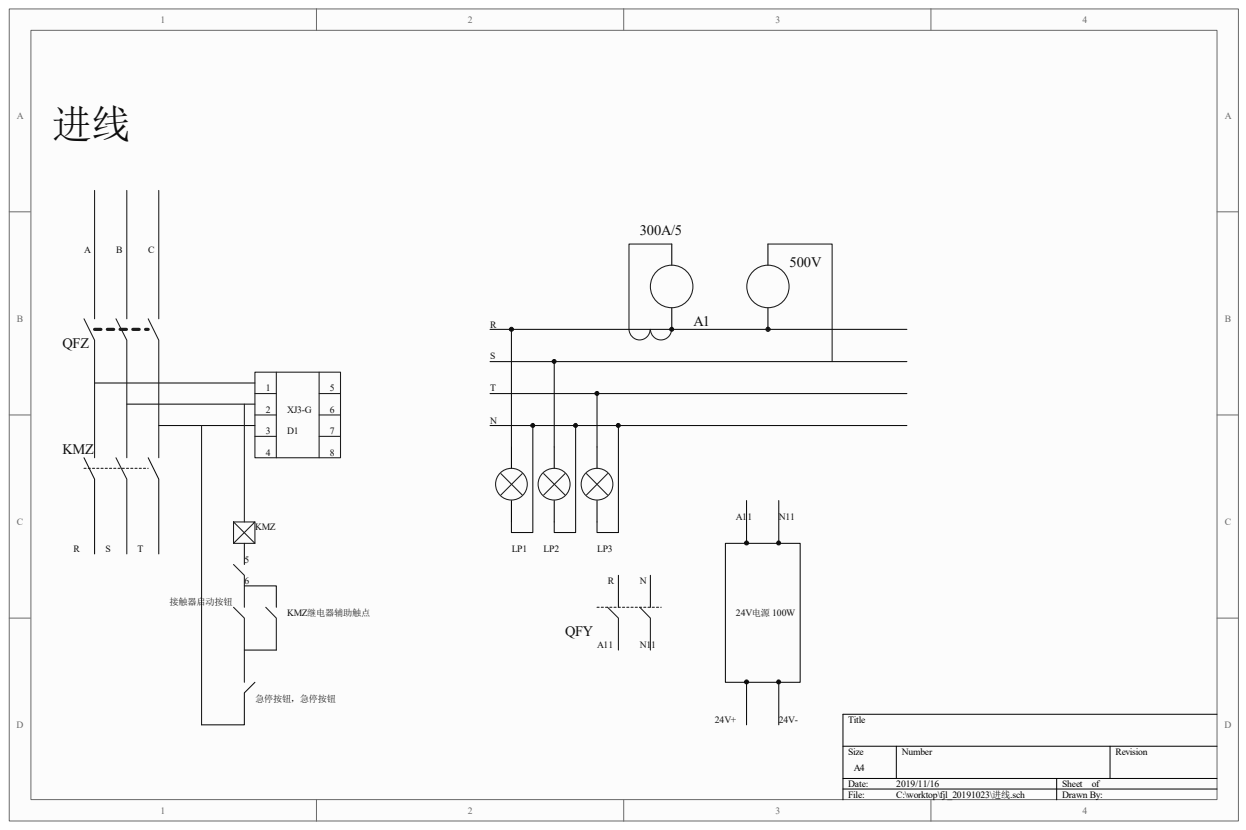
[picture p17: page 1]
Title; KMZ; QFZ; 24V电源 100W; 急停按钮，急停按钮 KMZ继电器辅助触点 接触器启动按钮; QFY R

Size A4 | Number | Revision

1 2 3 | File: C:\worktop\fjl_20191023\进线.sch | Drawn By: 4

Date: 2019/11/16 | Sheet of
