microsysdeve/fjl_sdlk/(commit log)

2019-08-30 初始递交
    [fjl_sdlk.xlsx]
2019-09-02 过程递交
    [fjl_sdlk.xlsx]
2019-09-16 合并庞召东
2019-09-26 采购时的递交
    [fjl_sdlk.xlsx]
2019-10-20 添加了大接触器启动控制
    [进线.sch]
2019-10-21 修性修性
    [plcunit.sch]
2019-10-28 小范厂内调试过版本
    [悬挂链.sch, 电泳.sch]
2019-10-28 清理了文件
    [Sheet14.Sch, Sheet15.Sch, Sheet3.Sch, Sheet4.Sch]
2020-01-31 工作区移除前的递交
